YipLab/plate_scanner/DesignFiles/linear_stage_plates.pdf

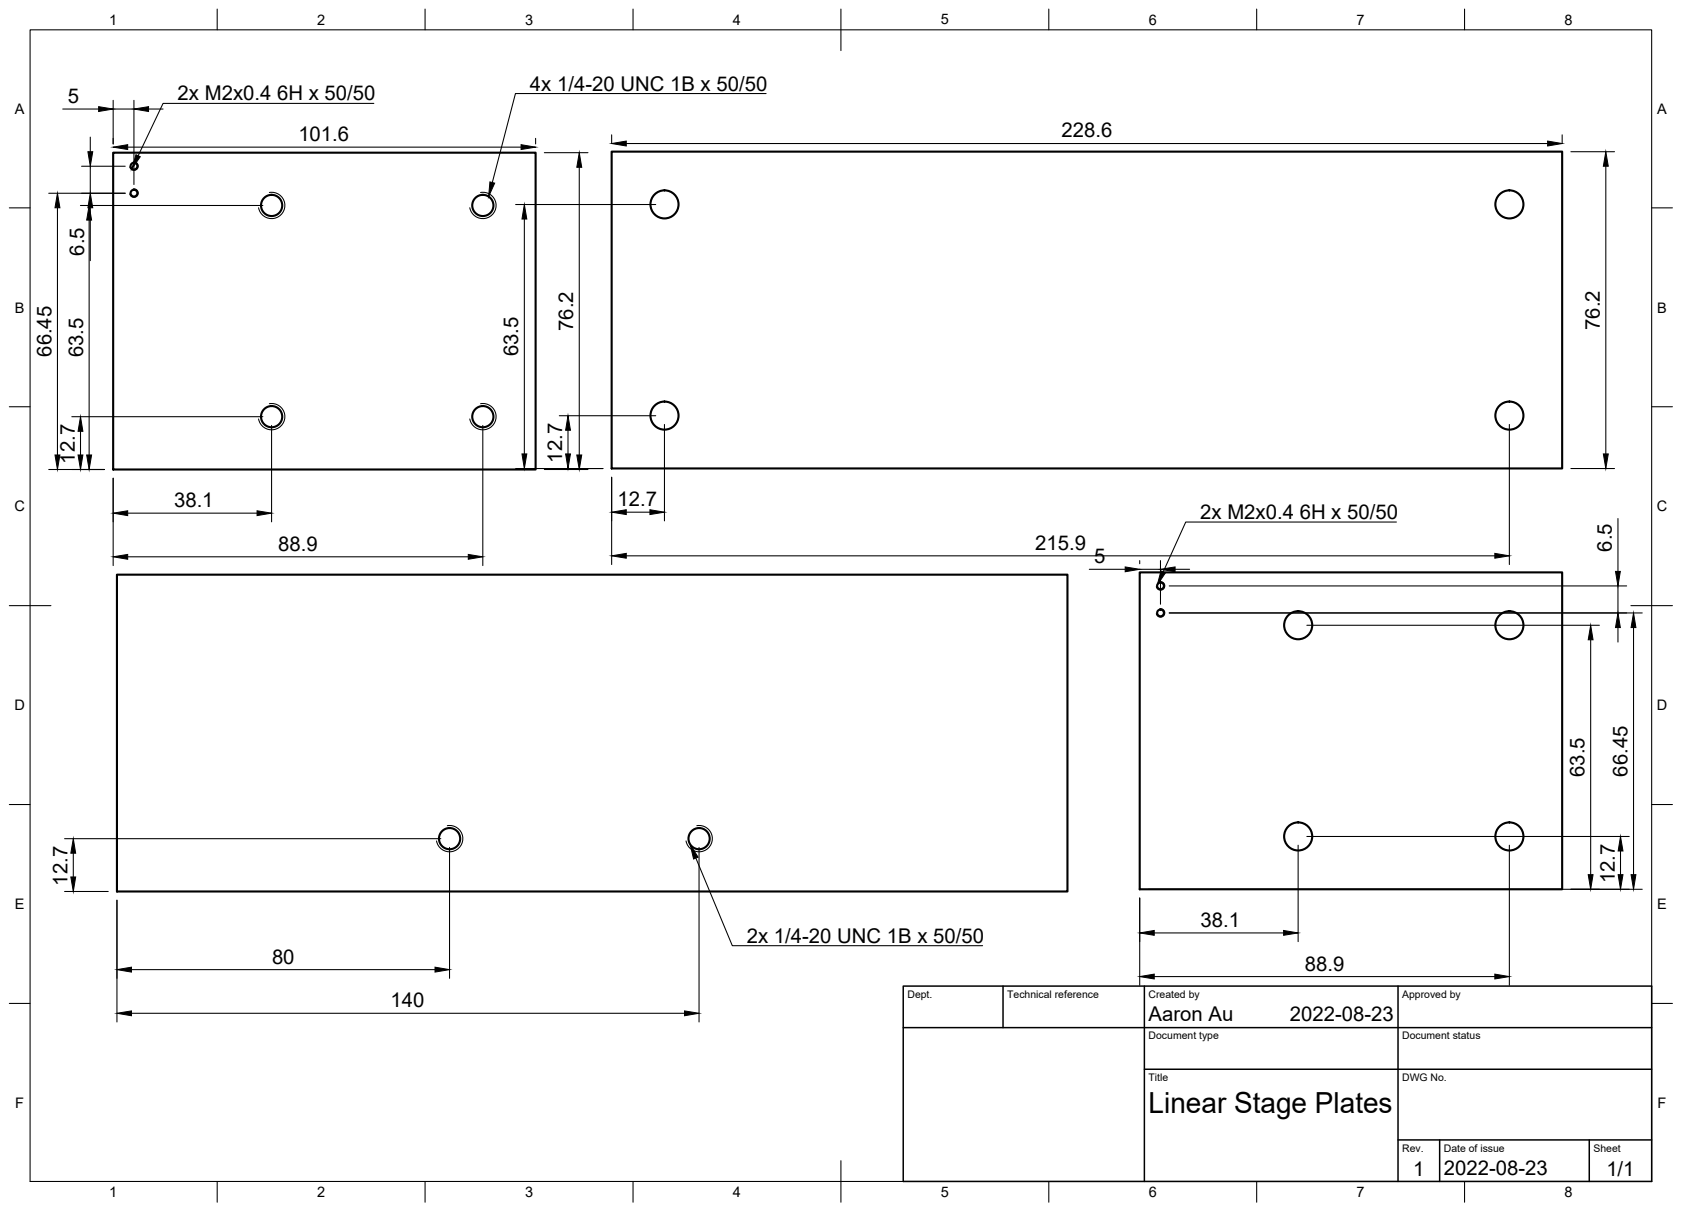
[picture p3: page 1]
Title; DWG No.; Rev.; Date of issue; Sheet; 4x 1/4-20 UNC 1B x 50/50; 2x 1/4-20 UNC 1B x 50/50

Dept. | Technical reference | Created by Aaron Au 2022-08-23 | Approved by

Document type | Document status

Linear Stage Plates
