YipLab/plate_scanner/(commit log)

2017-08-22 Inital Content
    Arduino Code - Move with esp300 like commands
    Python GUI - with buttons to move to focusing points, and acquire images.
2017-08-22 CameraConfig
    Added Basler_L402k camera file
2017-08-23 Camera setup
2017-08-23 manual for arduinostage controller
2017-08-24 Added Light Relay
    Added a Relay to LED to turn on only when imaging.
2017-08-25 bug fixes + code opt
    Arduino code now outputs 1 when command is finished with a '/r/n'. Arduino code now takes decimals when sending serial.
    Python code has adj_y and adj_x that re-adjusts after a column is done.
    Python code optimized to send when line when multiple commands are sent.
    [PlateScannerArduino.ino, PlateScannerGUI.py]
2017-09-01 Fixed issue where scan plate would do intermittent scans
    [PlateScannerGUI.py]
2017-09-18 Plate Orientation
    added check box for naming images with well location
2017-09-18 Bug FIxes for Orientation and file naming
    [PlateScannerGUI.py]
2017-11-02 new scan system
    Long and short config files
    new platescannerGUI
    [PlateScannerGUI.py, winauto.py]
2017-11-08 fixed bug where scan plate cant scan more than once
    added ss.destory() to stop
    [PlateScannerGUI.py]
2017-11-27 singapore update
    added support for 24 well plate
    as well as choosing different wells to scan
2018-05-28 Flipped LED vhigh and lows
    [PlateScannerArduino.ino]
